riktw/jeadock/README.md

# jeadock
Dock for the Lichee RV to provide Ethernet, GPIO and more

More information on the related [blog post](https://justanotherelectronicsblog.com/?p=1107).
