riktw/jeadock/Case/enclosure_bottom.stp

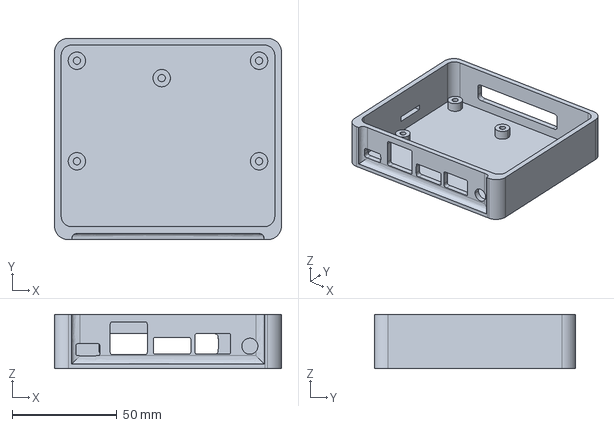
[picture p1: CAD file, 2022-04-30]
Case/enclosure_bottom.stp
108.4 x 96.2 x 26.0 mm
