riktw/jeadock/Case/enclosure_top.stp

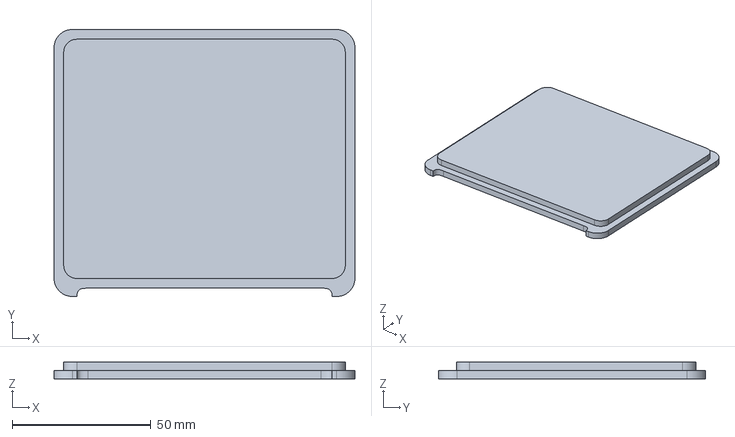
[picture p2: CAD file, 2022-04-30]
Case/enclosure_top.stp
108.4 x 96.2 x 6.00 mm
