riktw/jeadock/DOC/Schematic.pdf

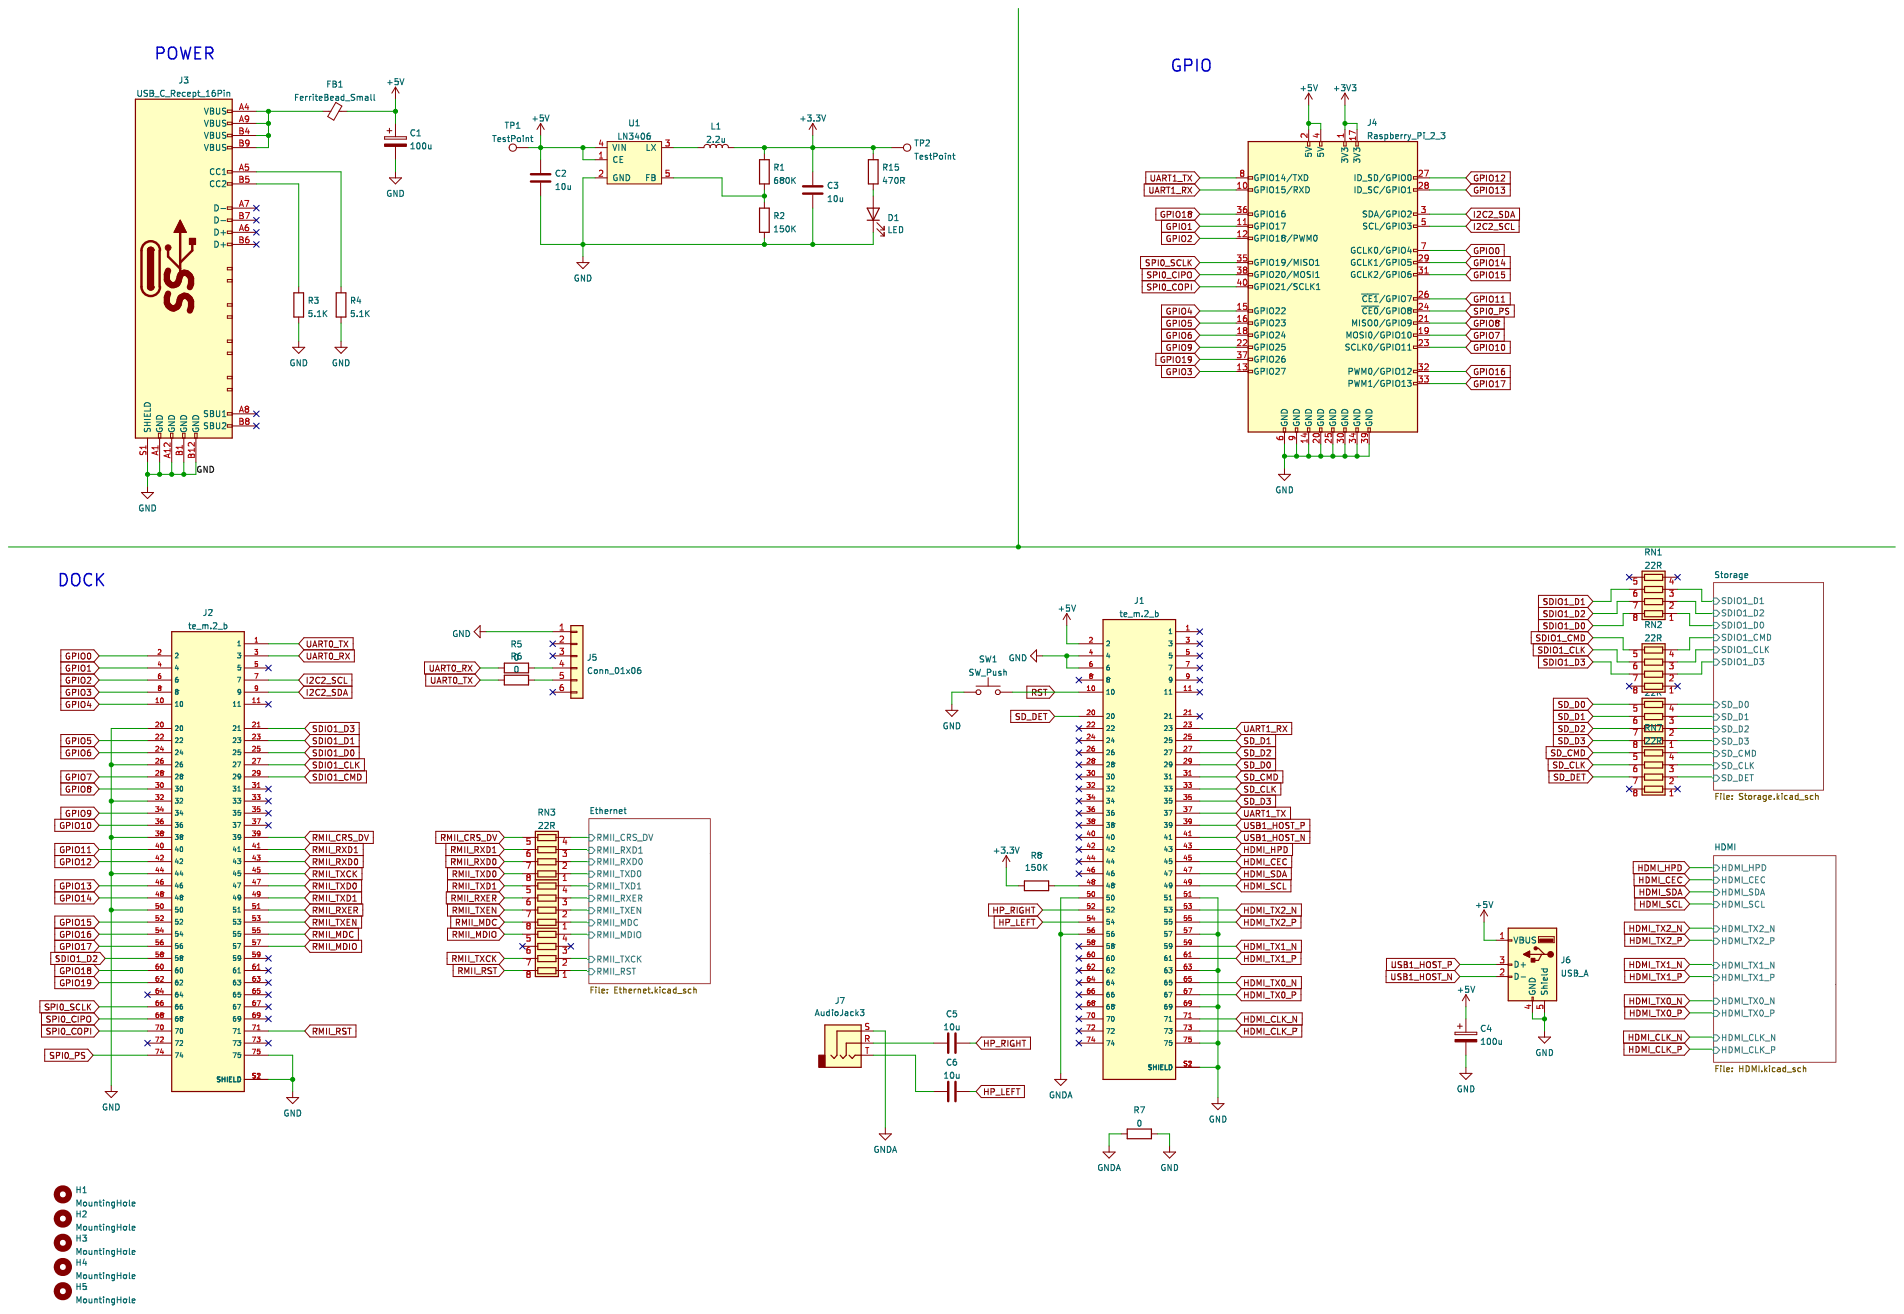
[picture p3: page 1]

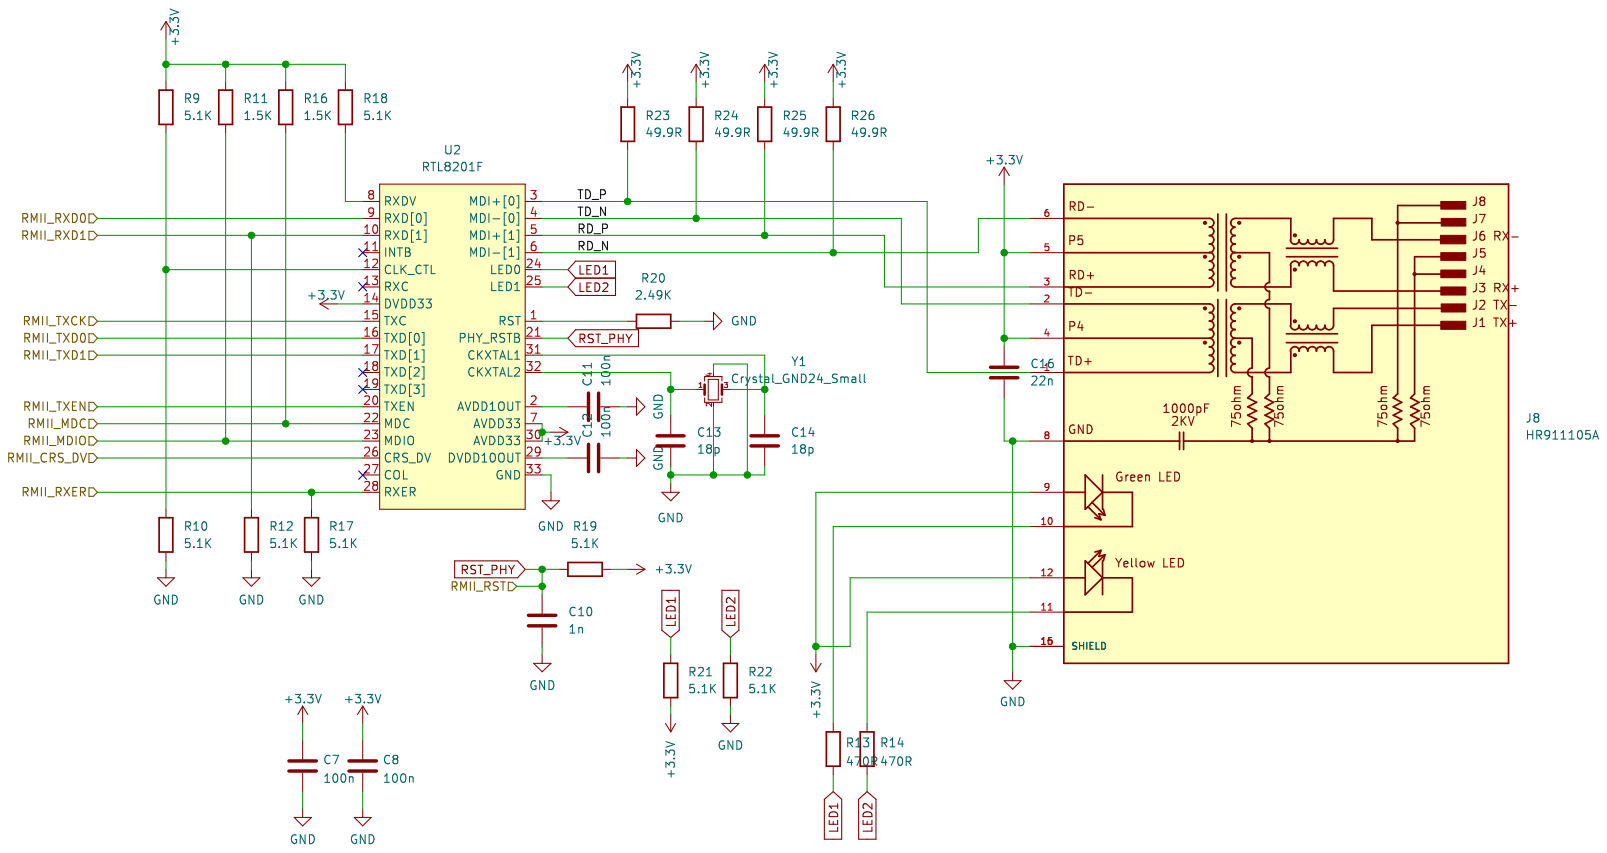
[picture p4: page 2]

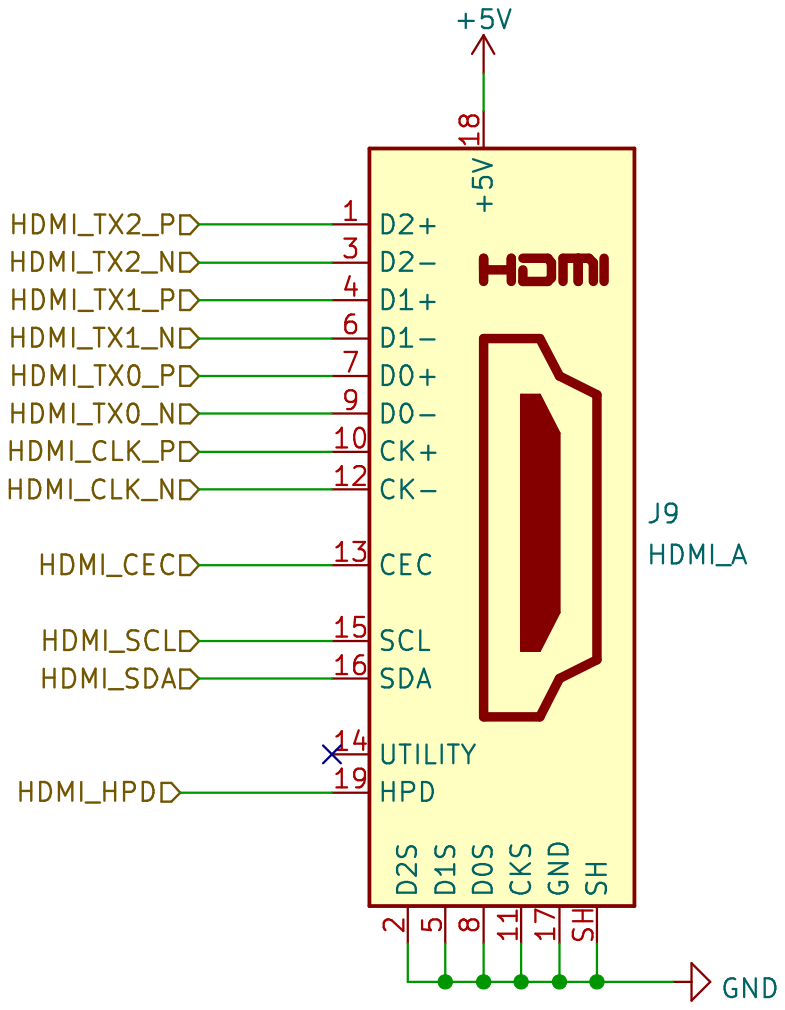
[picture p5: page 3]

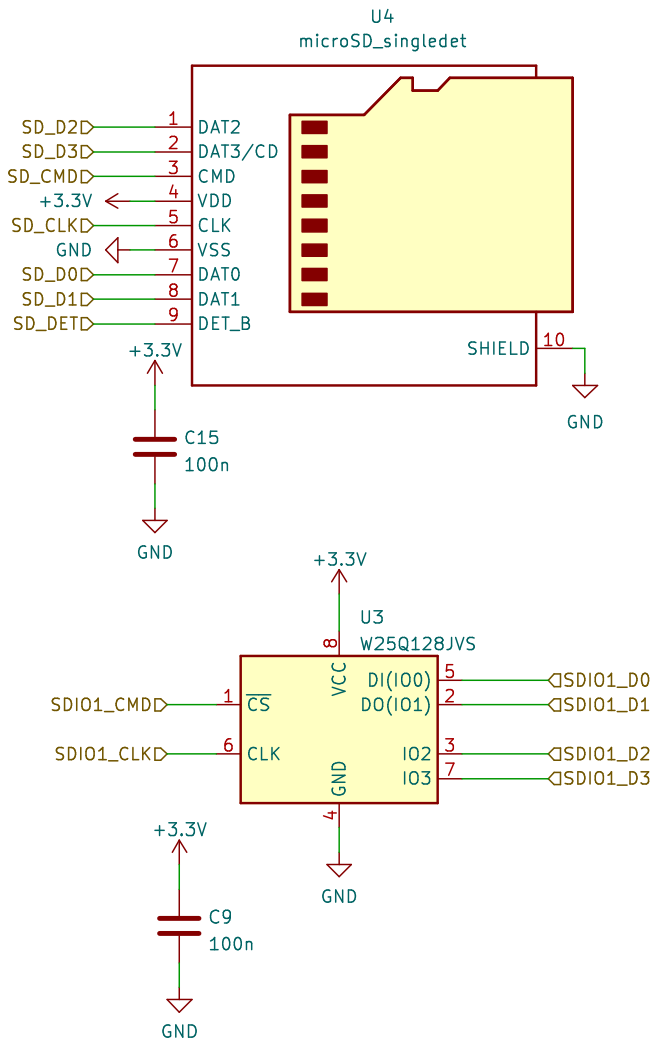
[picture p6: page 4]
