riktw/jeadock/HW/dock.kicad_pcb

## KiCad design HW/dock.kicad_pcb (2022-05-02)

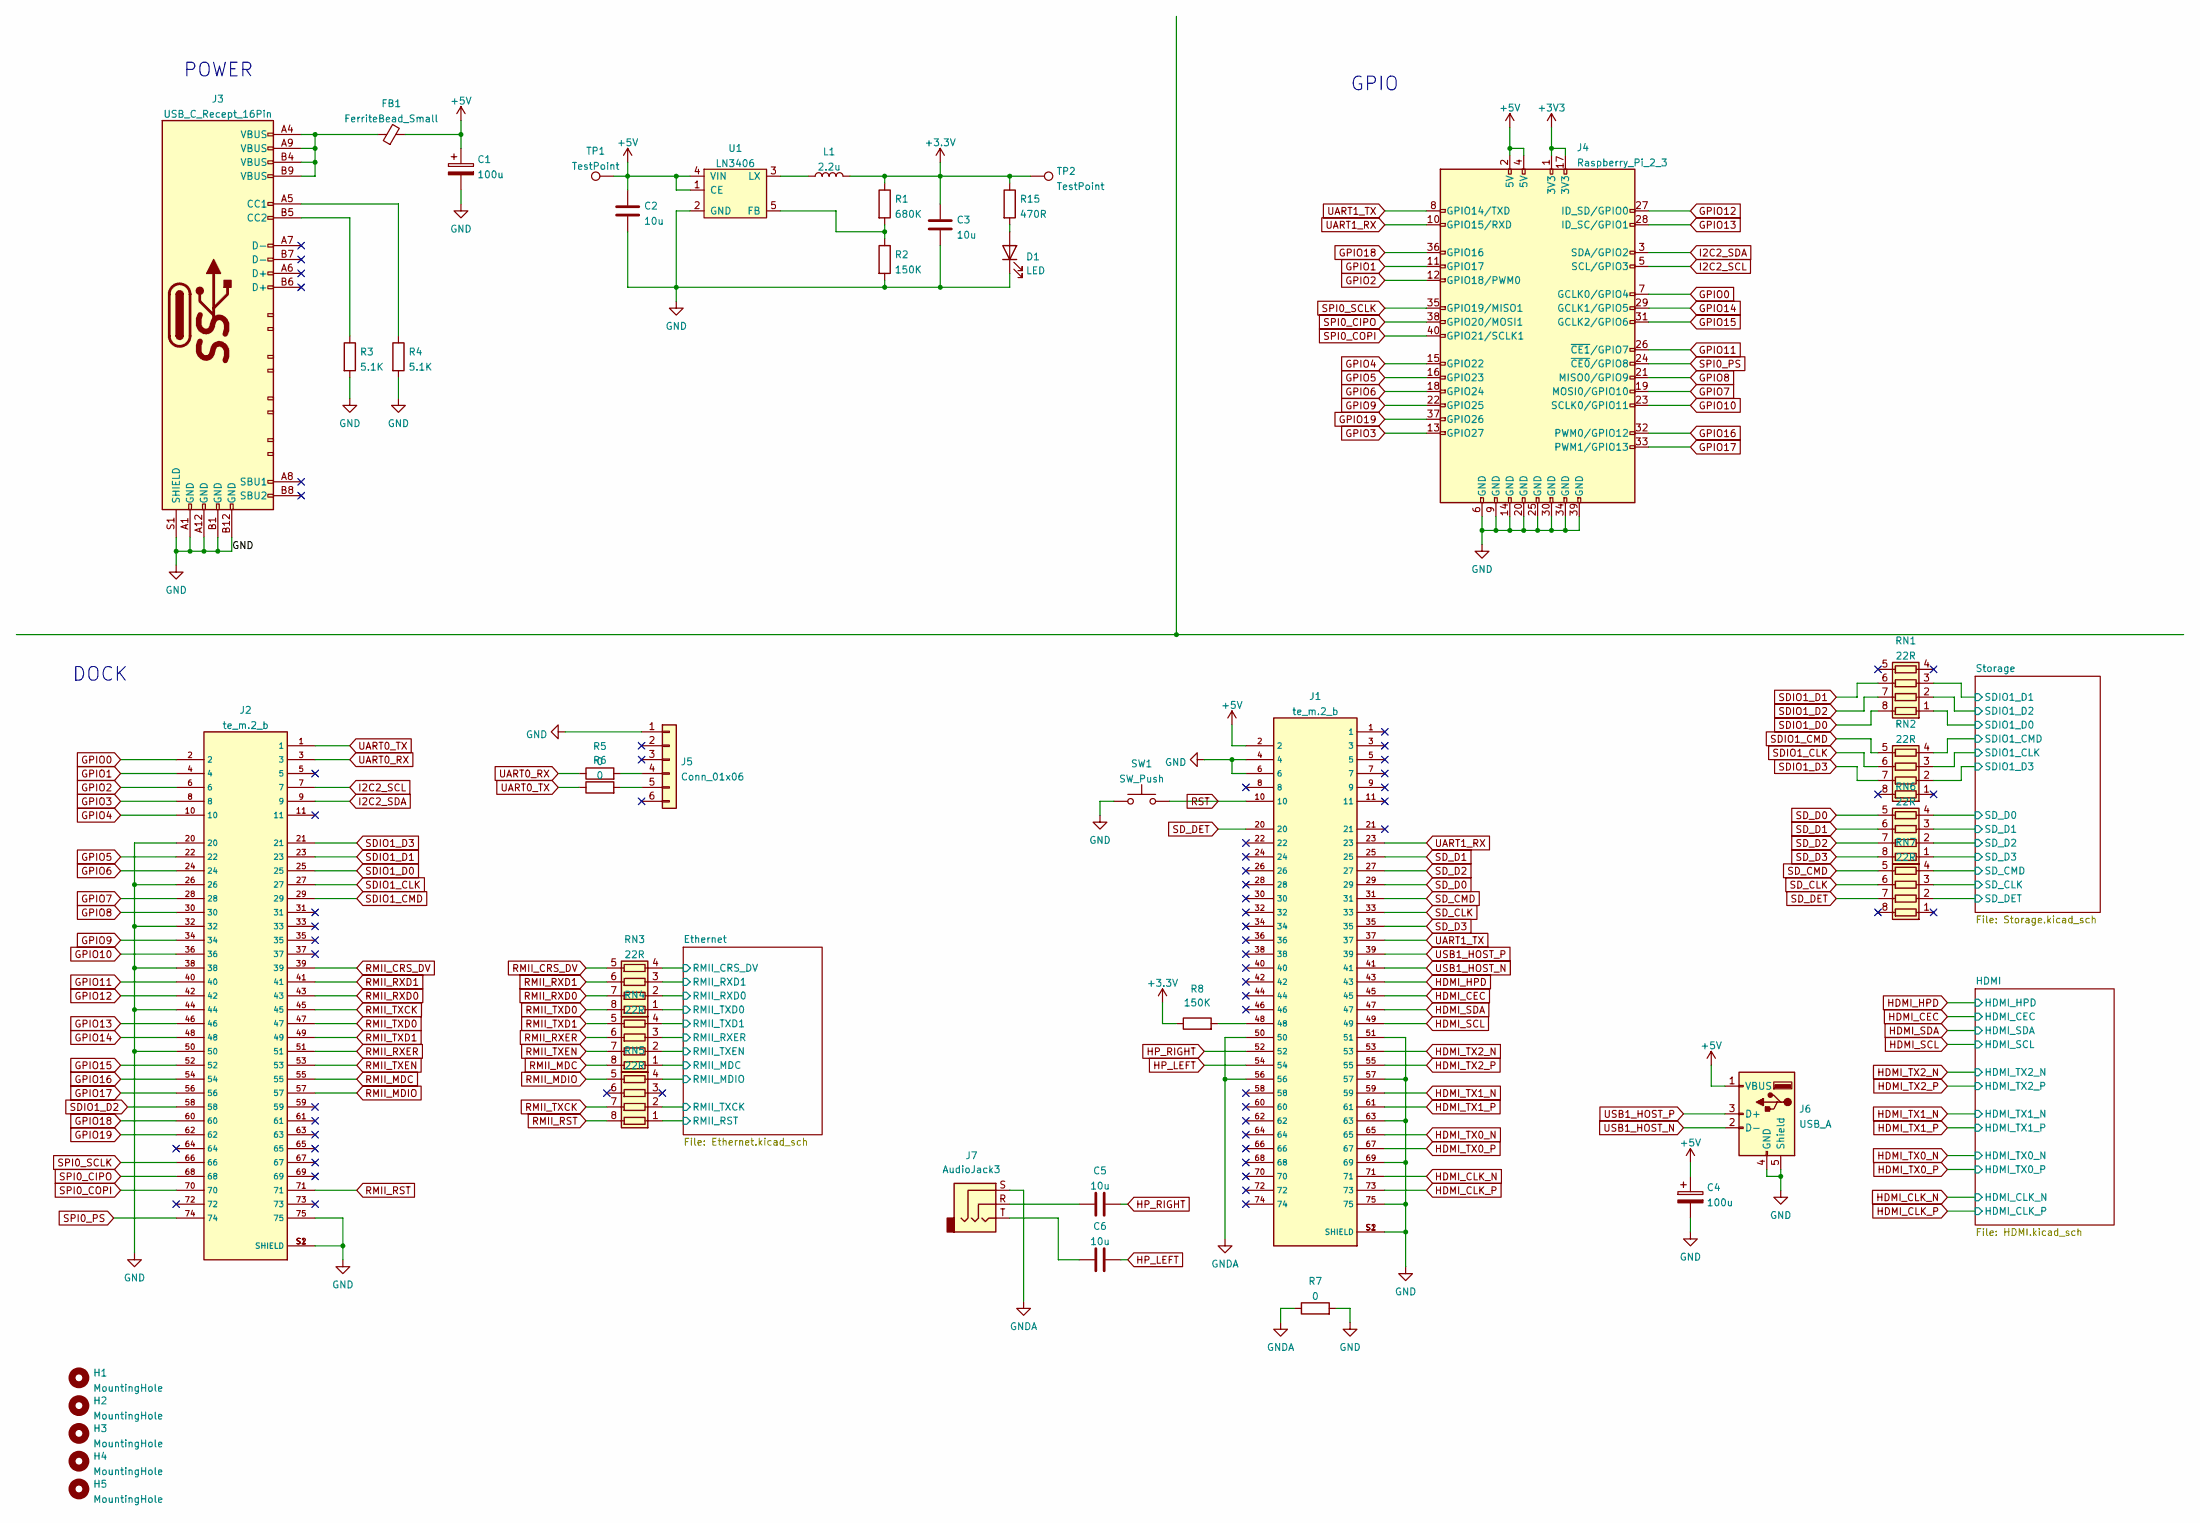
[picture p7: schematic dock.kicad_sch]

Parts:
C1, C4: 100u; CP_Elec_6.3x7.7
C2, C3, C5, C6: 10u; C_0603_1608Metric; JLC C96446
D1: LED; LED_0603_1608Metric; JLC C72043
FB1: FerriteBead_Small; L_0603_1608Metric
H1: MountingHole; MountingHole_2.2mm_M2
H2, H3, H4, H5: MountingHole; MountingHole_3.2mm_M3
J1, J2: te_m.2_b; TE_2199230-3; JLC C2761526
J3: USB_C_Recept_16Pin
J4: Raspberry_Pi_2_3; PinHeader_2x20_P2.54mm_Vertical
J5: Conn_01x06; PinHeader_1x06_P2.54mm_Vertical
J6: USB_A; USB_A_CONNFLY_DS1095-WNR0
J7: AudioJack3; audio_jack_3.5_C18167; JLC C18167
L1: 2.2u; L_0805_2012Metric_Pad1.15x1.40mm_HandSolder; Farnell 2776807
R1: 680K; R_0603_1608Metric; JLC C25822
R2, R8: 150K; R_0603_1608Metric; JLC C22807
R3, R4: 5.1K; R_0603_1608Metric; JLC C23186
R5, R6, R7: 0; R_0603_1608Metric
R15: 470R; R_0603_1608Metric
RN1, RN2, RN3, RN4, RN5, RN6, RN7: 22R; R_Array_Convex_4x0402; Farnell 3550014
SW1: SW_Push; SW_SPST_CK_RS282G05A3
TP1, TP2: TestPoint; TestPoint_Pad_1.5x1.5mm
U1: LN3406; SOT-23-5; JLC C190828

Connections:
+5V: C1.1, C2.1, C4.1, FB1.2, J1.2, J4.2 (5V), J4.4 (5V), J6.1 (VBUS), TP1.1, U1.1 (CE), U1.4 (VIN); also elsewhere on the board
/Ethernet/RMII_CRS_DV: RN3.4 (R4.1); also elsewhere on the board
/Ethernet/RMII_MDC: RN4.1 (R1.1); also elsewhere on the board
/Ethernet/RMII_MDIO: RN5.4 (R4.1); also elsewhere on the board
/Ethernet/RMII_RXD0: RN3.2 (R2.1); also elsewhere on the board
/Ethernet/RMII_RXD1: RN3.3 (R3.1); also elsewhere on the board
/Ethernet/RMII_RXER: RN4.3 (R3.1); also elsewhere on the board
/Ethernet/RMII_TXCK: RN5.2 (R2.1); also elsewhere on the board
/Ethernet/RMII_TXD0: RN3.1 (R1.1); also elsewhere on the board
/Ethernet/RMII_TXD1: RN4.4 (R4.1); also elsewhere on the board
/Ethernet/RMII_TXEN: RN4.2 (R2.1); also elsewhere on the board
/Storage/SDIO1_CLK: RN2.3 (R3.1); also elsewhere on the board
/Storage/SDIO1_CMD: RN2.4 (R4.1); also elsewhere on the board
/Storage/SDIO1_D0: RN1.1 (R1.1); also elsewhere on the board
/Storage/SDIO1_D1: RN1.3 (R3.1); also elsewhere on the board
/Storage/SDIO1_D2: RN1.2 (R2.1); also elsewhere on the board
/Storage/SDIO1_D3: RN2.2 (R2.1); also elsewhere on the board
/Storage/SD_CLK: RN7.3 (R3.1); also elsewhere on the board
/Storage/SD_CMD: RN7.4 (R4.1); also elsewhere on the board
/Storage/SD_D0: RN6.4 (R4.1); also elsewhere on the board
/Storage/SD_D1: RN6.3 (R3.1); also elsewhere on the board
/Storage/SD_D2: RN6.2 (R2.1); also elsewhere on the board
/Storage/SD_D3: RN6.1 (R1.1); also elsewhere on the board
/Storage/SD_DET: RN7.2 (R2.1); also elsewhere on the board
GND: C1.2, C2.2, C3.2, C4.2, D1.1 (K), J1.4, J1.6, J1.51, J1.57, J1.63, J1.69, J1.75, J1.S1 (SHIELD), J1.S2 (SHIELD), J2.20, J2.26, J2.32, J2.38, J2.44, J2.50, J2.75, J2.S1 (SHIELD), J2.S2 (SHIELD), J3.A1 (GND), J3.A12 (GND), J3.B1 (GND), J3.B12 (GND), J3.S1 (SHIELD), J4.6 (GND), J4.9 (GND), J4.14 (GND), J4.20 (GND), J4.25 (GND), J4.30 (GND), J4.34 (GND), J4.39 (GND), J5.1, J6.4 (GND), J6.5 (Shield), R2.2, R3.2, R4.2, R7.2, SW1.1, U1.2 (GND); also elsewhere on the board
GNDA: J1.50, J1.56, J7.S, R7.1
GPIO0: J2.2, J4.7 (GCLK0/GPIO4)
GPIO1: J2.4, J4.11 (GPIO17)
GPIO2: J2.6, J4.12 (GPIO18/PWM0)
GPIO3: J2.8, J4.13 (GPIO27)
GPIO4: J2.10, J4.15 (GPIO22)
GPIO5: J2.22, J4.16 (GPIO23)
GPIO6: J2.24, J4.18 (GPIO24)
GPIO7: J2.28, J4.19 (MOSI0/GPIO10)
GPIO8: J2.30, J4.21 (MISO0/GPIO9)
GPIO9: J2.34, J4.22 (GPIO25)
GPIO10: J2.36, J4.23 (SCLK0/GPIO11)
GPIO11: J2.40, J4.26 (~CE1/GPIO7)
GPIO12: J2.42, J4.27 (ID_SD/GPIO0)
GPIO13: J2.46, J4.28 (ID_SC/GPIO1)
GPIO14: J2.48, J4.29 (GCLK1/GPIO5)
GPIO15: J2.52, J4.31 (GCLK2/GPIO6)
GPIO16: J2.54, J4.32 (PWM0/GPIO12)
GPIO17: J2.56, J4.33 (PWM1/GPIO13)
GPIO18: J2.60, J4.36 (GPIO16)
GPIO19: J2.62, J4.37 (GPIO26)
HDMI_CEC: J1.45; also elsewhere on the board
HDMI_CLK_N: J1.71; also elsewhere on the board
HDMI_CLK_P: J1.73; also elsewhere on the board
HDMI_HPD: J1.43; also elsewhere on the board
HDMI_SCL: J1.49; also elsewhere on the board
HDMI_SDA: J1.47; also elsewhere on the board
HDMI_TX0_N: J1.65; also elsewhere on the board
HDMI_TX0_P: J1.67; also elsewhere on the board
HDMI_TX1_N: J1.59; also elsewhere on the board
HDMI_TX1_P: J1.61; also elsewhere on the board
HDMI_TX2_N: J1.53; also elsewhere on the board
HDMI_TX2_P: J1.55; also elsewhere on the board
HP_LEFT: C6.2, J1.54
HP_RIGHT: C5.2, J1.52
I2C2_SCL: J2.7, J4.5 (SCL/GPIO3)
I2C2_SDA: J2.9, J4.3 (SDA/GPIO2)
unnamed: C5.1, J7.R
unnamed: C6.1, J7.T
unnamed: D1.2 (A), R15.2
unnamed: FB1.1, J3.A4 (VBUS), J3.A9 (VBUS), J3.B4 (VBUS), J3.B9 (VBUS)
unnamed: J1.48, R8.2
unnamed: J3.A5 (CC1), R4.1
unnamed: J3.B5 (CC2), R3.1
unnamed: J5.4, R5.2
unnamed: J5.5, R6.2
unnamed: L1.1, U1.3 (LX)
unnamed: R1.2, R2.1, U1.5 (FB)
RMII_CRS_DV: J2.39, RN3.5 (R4.2)
RMII_MDC: J2.55, RN4.8 (R1.2)
RMII_MDIO: J2.57, RN5.5 (R4.2)
RMII_RST: J2.71, RN5.8 (R1.2)
RMII_RXD0: J2.43, RN3.7 (R2.2)
RMII_RXD1: J2.41, RN3.6 (R3.2)
RMII_RXER: J2.51, RN4.6 (R3.2)
RMII_TXCK: J2.45, RN5.7 (R2.2)
RMII_TXD0: J2.47, RN3.8 (R1.2)
RMII_TXD1: J2.49, RN4.5 (R4.2)
RMII_TXEN: J2.53, RN4.7 (R2.2)
RST: J1.10, SW1.2
RST_PHY: RN5.1 (R1.1); also elsewhere on the board
SDIO1_CLK: J2.27, RN2.6 (R3.2)
SDIO1_CMD: J2.29, RN2.5 (R4.2)
SDIO1_D0: J2.25, RN1.8 (R1.2)
SDIO1_D1: J2.23, RN1.6 (R3.2)
SDIO1_D2: J2.58, RN1.7 (R2.2)
SDIO1_D3: J2.21, RN2.7 (R2.2)
SD_CLK: J1.33, RN7.6 (R3.2)
SD_CMD: J1.31, RN7.5 (R4.2)
SD_D0: J1.29, RN6.5 (R4.2)
SD_D1: J1.25, RN6.6 (R3.2)
SD_D2: J1.27, RN6.7 (R2.2)
SD_D3: J1.35, RN6.8 (R1.2)
SD_DET: J1.20, RN7.7 (R2.2)
SPI0_CIPO: J2.68, J4.38 (GPIO20/MOSI1)
SPI0_COPI: J2.70, J4.40 (GPIO21/SCLK1)
SPI0_PS: J2.74, J4.24 (~CE0/GPIO8)
SPI0_SCLK: J2.66, J4.35 (GPIO19/MISO1)
UART0_RX: J2.3, R5.1
UART0_TX: J2.1, R6.1
UART1_RX: J1.23, J4.10 (GPIO15/RXD)
UART1_TX: J1.37, J4.8 (GPIO14/TXD)
USB1_HOST_N: J1.41, J6.2 (D-)
USB1_HOST_P: J1.39, J6.3 (D+)

Notes on the sheet:
GPIO
POWER
DOCK

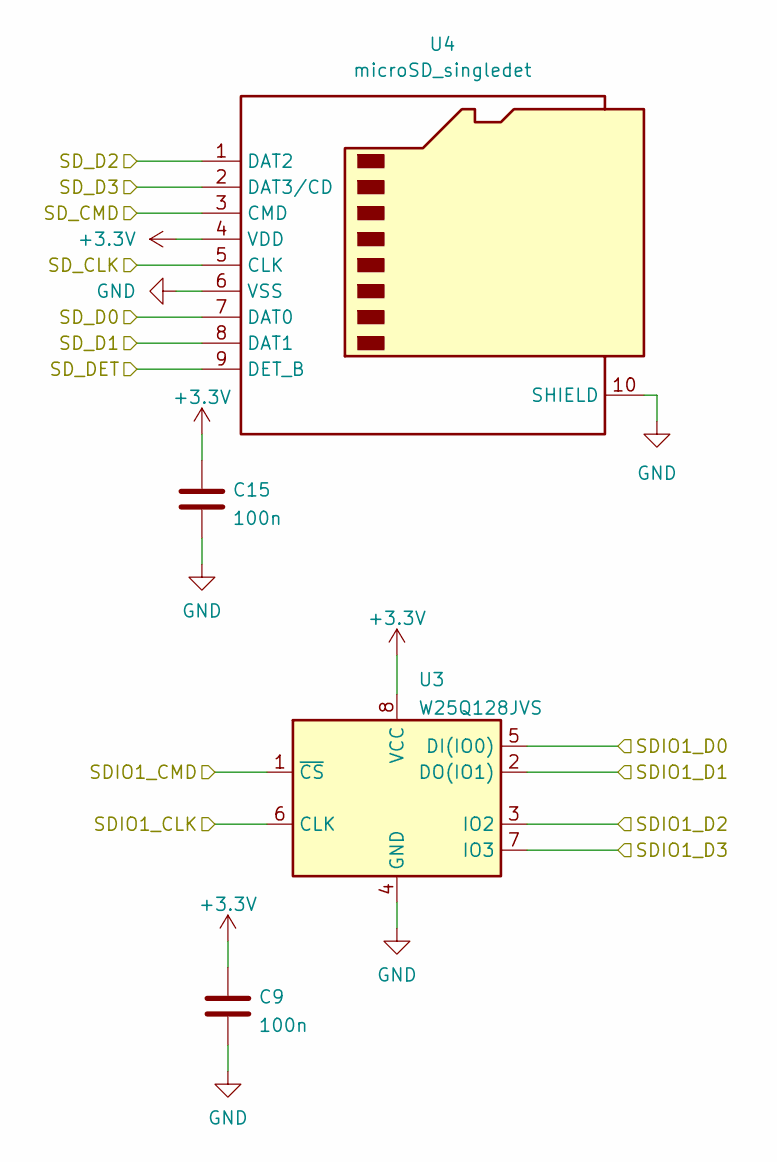
[picture p8: schematic Storage.kicad_sch]

Parts:
C9, C15: 100n; C_0603_1608Metric; JLC C14663
U3: W25Q128JVS; SOIC-8_5.23x5.23mm_P1.27mm; JLC C97521
U4: microSD_singledet; microSD Hanbo Electronic TF-018; JLC C961679

Connections:
/Storage/SDIO1_CLK: U3.6 (CLK); also elsewhere on the board
/Storage/SDIO1_CMD: U3.1 (~CS); also elsewhere on the board
/Storage/SDIO1_D0: U3.5 (DI(IO0)); also elsewhere on the board
/Storage/SDIO1_D1: U3.2 (DO(IO1)); also elsewhere on the board
/Storage/SDIO1_D2: U3.3 (IO2); also elsewhere on the board
/Storage/SDIO1_D3: U3.7 (IO3); also elsewhere on the board
/Storage/SD_CLK: U4.5 (CLK); also elsewhere on the board
/Storage/SD_CMD: U4.3 (CMD); also elsewhere on the board
/Storage/SD_D0: U4.7 (DAT0); also elsewhere on the board
/Storage/SD_D1: U4.8 (DAT1); also elsewhere on the board
/Storage/SD_D2: U4.1 (DAT2); also elsewhere on the board
/Storage/SD_D3: U4.2 (DAT3/CD); also elsewhere on the board
/Storage/SD_DET: U4.9 (DET_B); also elsewhere on the board
GND: C9.2, C15.2, U3.4 (GND), U4.6 (VSS), U4.10 (SHIELD); also elsewhere on the board

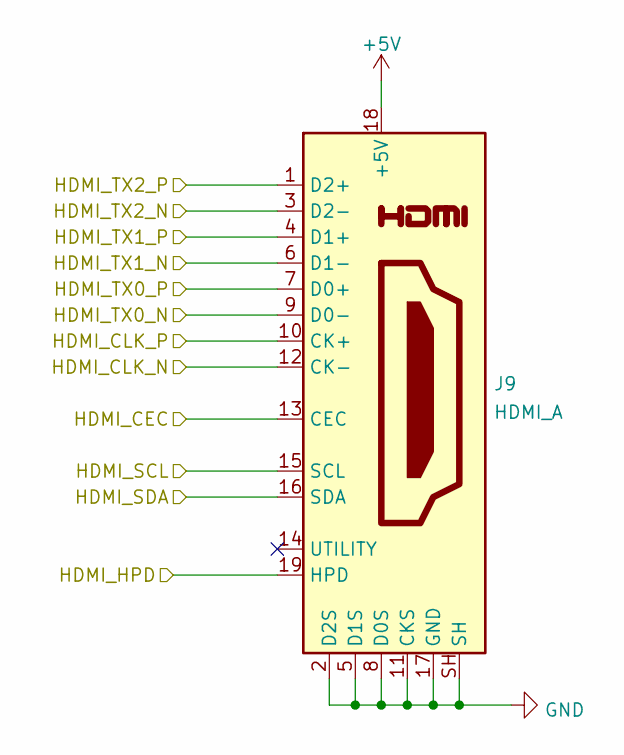
[picture p9: schematic HDMI.kicad_sch]

Parts:
J9: HDMI_A; HDMI_A_XUNPU_HDMI-001S; JLC C720616

Connections:
+5V: J9.18 (+5V); also elsewhere on the board
GND: J9.2 (D2S), J9.5 (D1S), J9.8 (D0S), J9.11 (CKS), J9.17 (GND), J9.SH; also elsewhere on the board
HDMI_CEC: J9.13 (CEC); also elsewhere on the board
HDMI_CLK_N: J9.12 (CK-); also elsewhere on the board
HDMI_CLK_P: J9.10 (CK+); also elsewhere on the board
HDMI_HPD: J9.19 (HPD); also elsewhere on the board
HDMI_SCL: J9.15 (SCL); also elsewhere on the board
HDMI_SDA: J9.16 (SDA); also elsewhere on the board
HDMI_TX0_N: J9.9 (D0-); also elsewhere on the board
HDMI_TX0_P: J9.7 (D0+); also elsewhere on the board
HDMI_TX1_N: J9.6 (D1-); also elsewhere on the board
HDMI_TX1_P: J9.4 (D1+); also elsewhere on the board
HDMI_TX2_N: J9.3 (D2-); also elsewhere on the board
HDMI_TX2_P: J9.1 (D2+); also elsewhere on the board

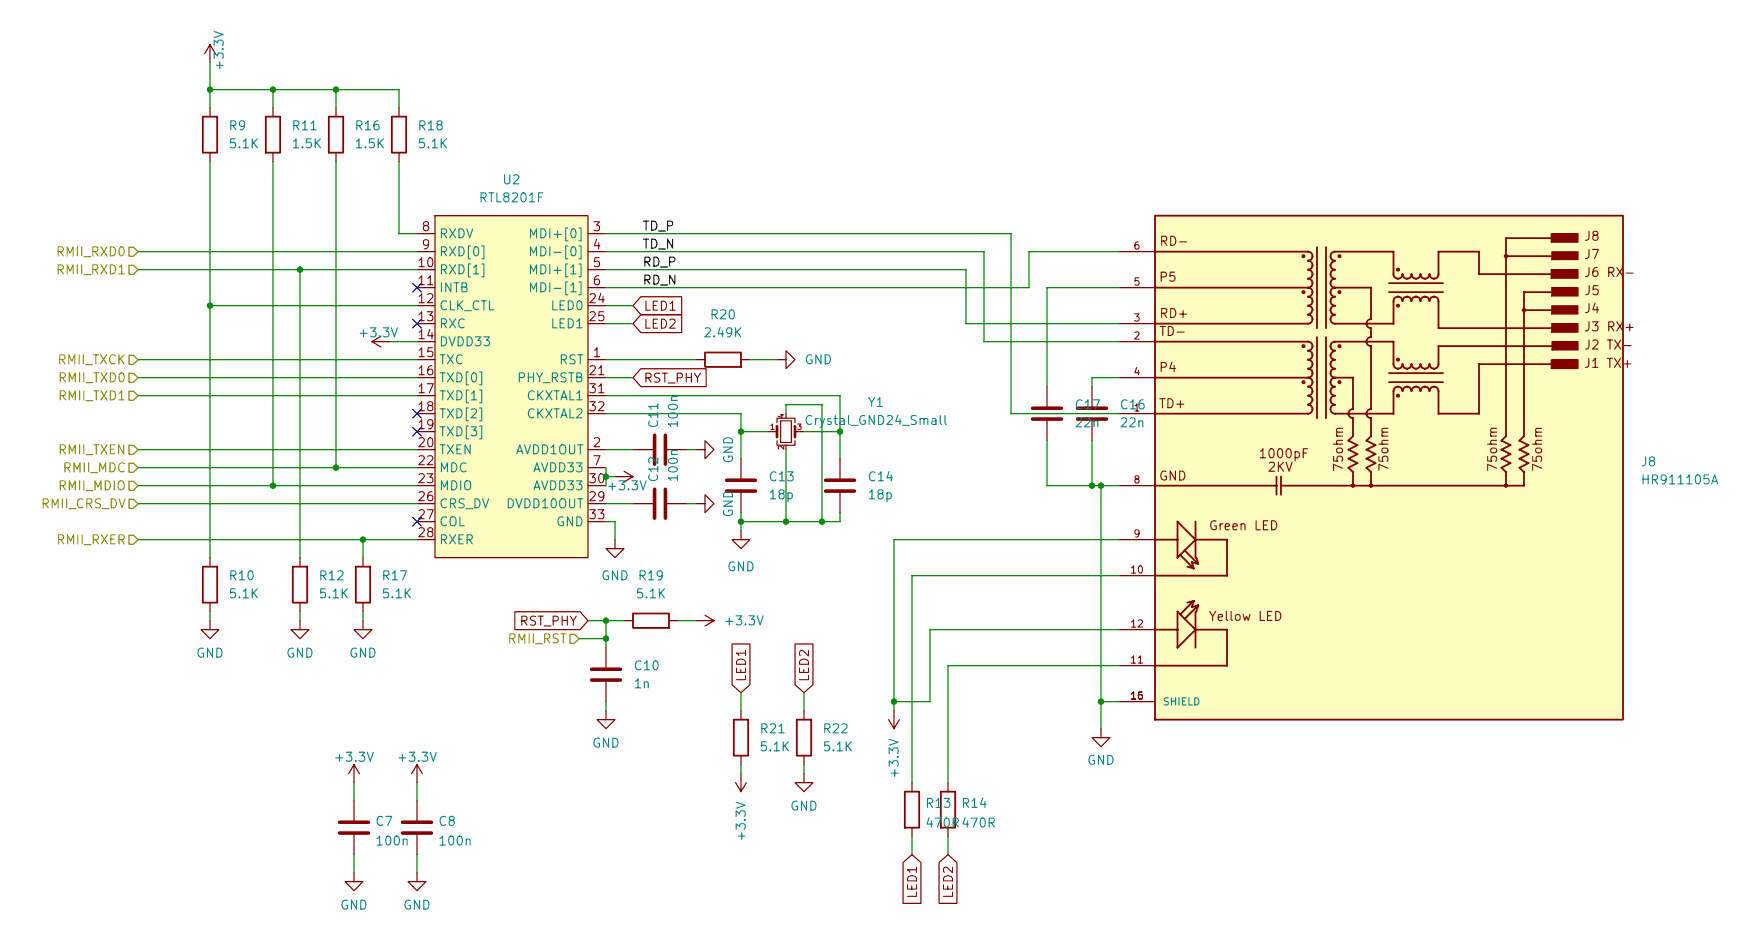
[picture p10: schematic Ethernet.kicad_sch]

Parts:
C7, C8, C11, C12: 100n; C_0402_1005Metric; JLC C307331
C10: 1n; C_0402_1005Metric; JLC C1523
C13, C14: 18p; C_0603_1608Metric; JLC C1647
C16, C17: 22n; C_0603_1608Metric; JLC C1647
J8: HR911105A; HANRUN_HR911105A; PARTREV A; JLC C12074
R9, R10: 5.1K; R_0603_1608Metric
R11, R16: 1.5K; R_0603_1608Metric; JLC C22843
R12, R17, R18, R19, R21, R22: 5.1K; R_0603_1608Metric; JLC C23186
R13, R14: 470R; R_0603_1608Metric
R20: 2.49K; R_0603_1608Metric
U2: RTL8201F; QFN-32-1EP_5x5mm_P0.5mm_EP3.3x3.3mm; JLC C45044
Y1: Crystal_GND24_Small; Crystal_SMD_3225-4Pin_3.2x2.5mm; JLC C90913

Connections:
/Ethernet/RD_N: J8.6, U2.6 (MDI-[1]); also elsewhere on the board
/Ethernet/RD_P: J8.3, U2.5 (MDI+[1]); also elsewhere on the board
/Ethernet/RMII_CRS_DV: U2.26 (CRS_DV); also elsewhere on the board
/Ethernet/RMII_MDC: R16.2, U2.22 (MDC); also elsewhere on the board
/Ethernet/RMII_MDIO: R11.2, U2.23 (MDIO); also elsewhere on the board
/Ethernet/RMII_RXD0: U2.9 (RXD[0]); also elsewhere on the board
/Ethernet/RMII_RXD1: R12.2, U2.10 (RXD[1]); also elsewhere on the board
/Ethernet/RMII_RXER: R17.2, U2.28 (RXER); also elsewhere on the board
/Ethernet/RMII_TXCK: U2.15 (TXC); also elsewhere on the board
/Ethernet/RMII_TXD0: U2.16 (TXD[0]); also elsewhere on the board
/Ethernet/RMII_TXD1: U2.17 (TXD[1]); also elsewhere on the board
/Ethernet/RMII_TXEN: U2.20 (TXEN); also elsewhere on the board
/Ethernet/TD_N: J8.2, U2.4 (MDI-[0]); also elsewhere on the board
/Ethernet/TD_P: J8.1, U2.3 (MDI+[0]); also elsewhere on the board
GND: C7.2, C8.2, C10.2, C11.2, C12.2, C13.2, C14.2, C16.2, C17.2, J8.8, J8.15 (SHIELD), J8.16 (SHIELD), R10.1, R12.1, R17.1, R20.2, R22.1, U2.33 (GND), Y1.2, Y1.4; also elsewhere on the board
LED1: R13.2, R21.2, U2.24 (LED0)
LED2: R14.2, R22.2, U2.25 (LED1)
unnamed: C11.1, U2.2 (AVDD1OUT)
unnamed: C12.1, U2.29 (DVDD10OUT)
unnamed: C13.1, U2.32 (CKXTAL2), Y1.1
unnamed: C14.1, U2.31 (CKXTAL1), Y1.3
unnamed: C16.1, J8.4
unnamed: C17.1, J8.5
unnamed: J8.10, R13.1
unnamed: J8.11, R14.1
unnamed: R9.1, R10.2, U2.12 (CLK_CTL)
unnamed: R18.1, U2.8 (RXDV)
unnamed: R20.1, U2.1 (RST)
RST_PHY: C10.1, R19.1, U2.21 (PHY_RSTB); also elsewhere on the board

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
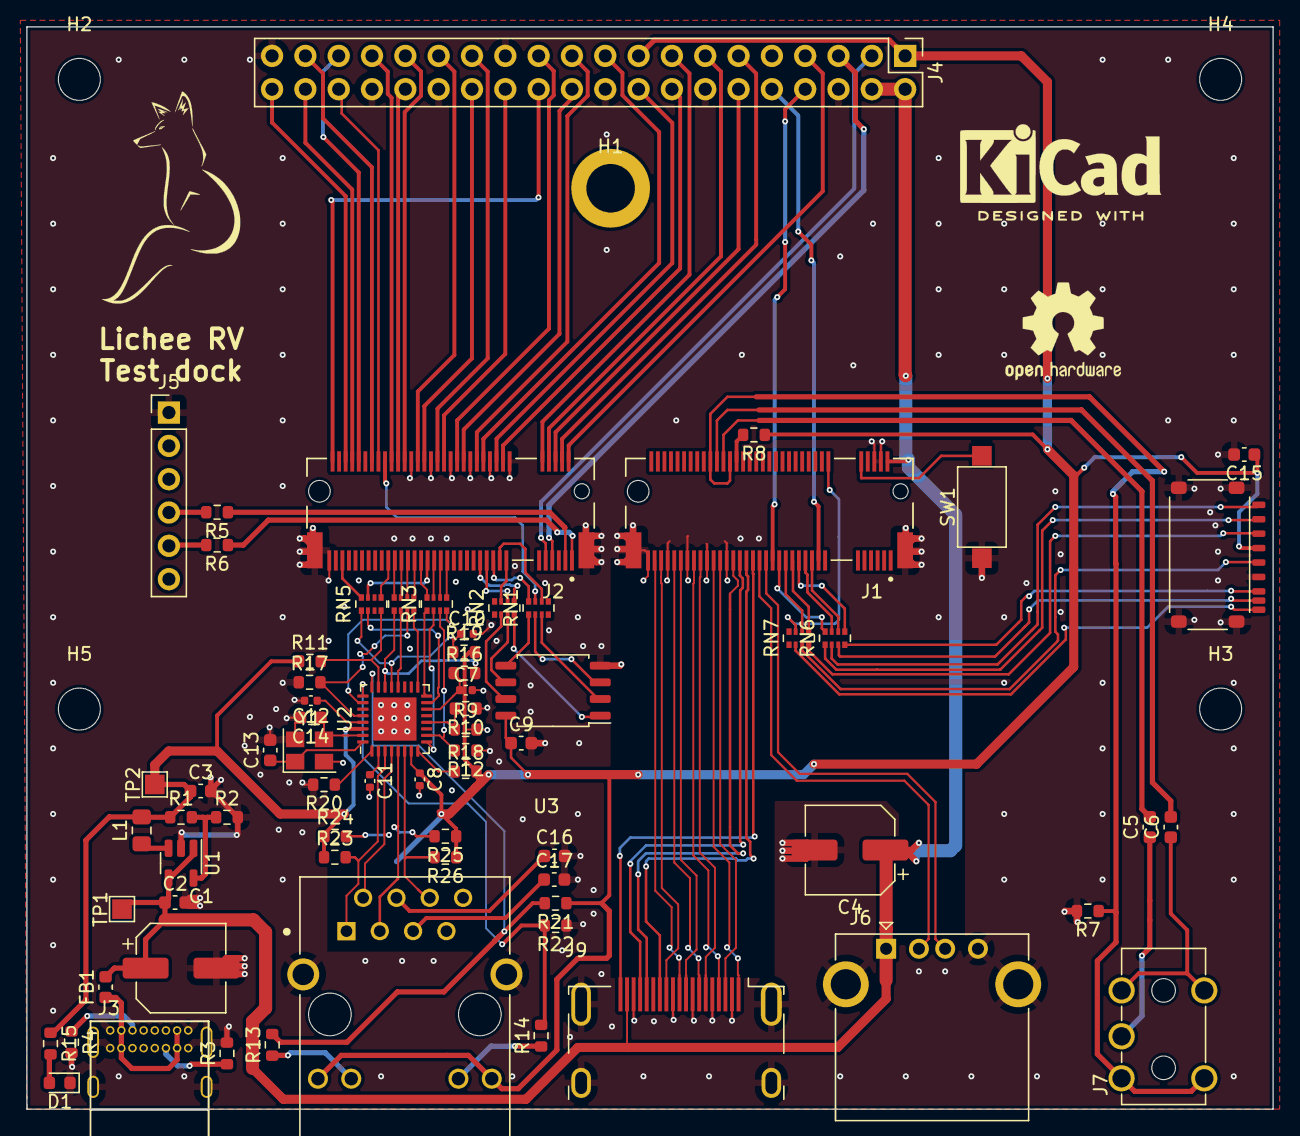
[picture p11: board dock.kicad_pcb from above]

Board: 4 copper layers, 95.0 x 82.5 mm, 75 parts (0 on the bottom side), 127 nets.

Other parts of the board:
R23, R24, R25, R26: 49.9R; R_0603_1608Metric

Their connections:
/Ethernet/RD_N: R26.2; also elsewhere on the board
/Ethernet/RD_P: R25.2; also elsewhere on the board
/Ethernet/TD_N: R24.2; also elsewhere on the board
/Ethernet/TD_P: R23.2; also elsewhere on the board
