riktw/jeadock/(commit log)

2022-04-24 Added initial hardware
    [BOM-dock.csv, Ethernet.kicad_sch, HDMI.kicad_sch, Storage.kicad_sch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]
2022-04-24 Added schematic in pdf and pinout
2022-04-30 Added initial SW to create an arch image for the dock, added case files
    [enclosure_bottom.stp, enclosure_top.stp]
2022-05-02 Small fixes to HW
    [Ethernet.kicad_sch, dock.kicad_pcb, dock.kicad_sch]
